kylewetton/pedal-division-kicad-library/resources/125B_design_template.pdf

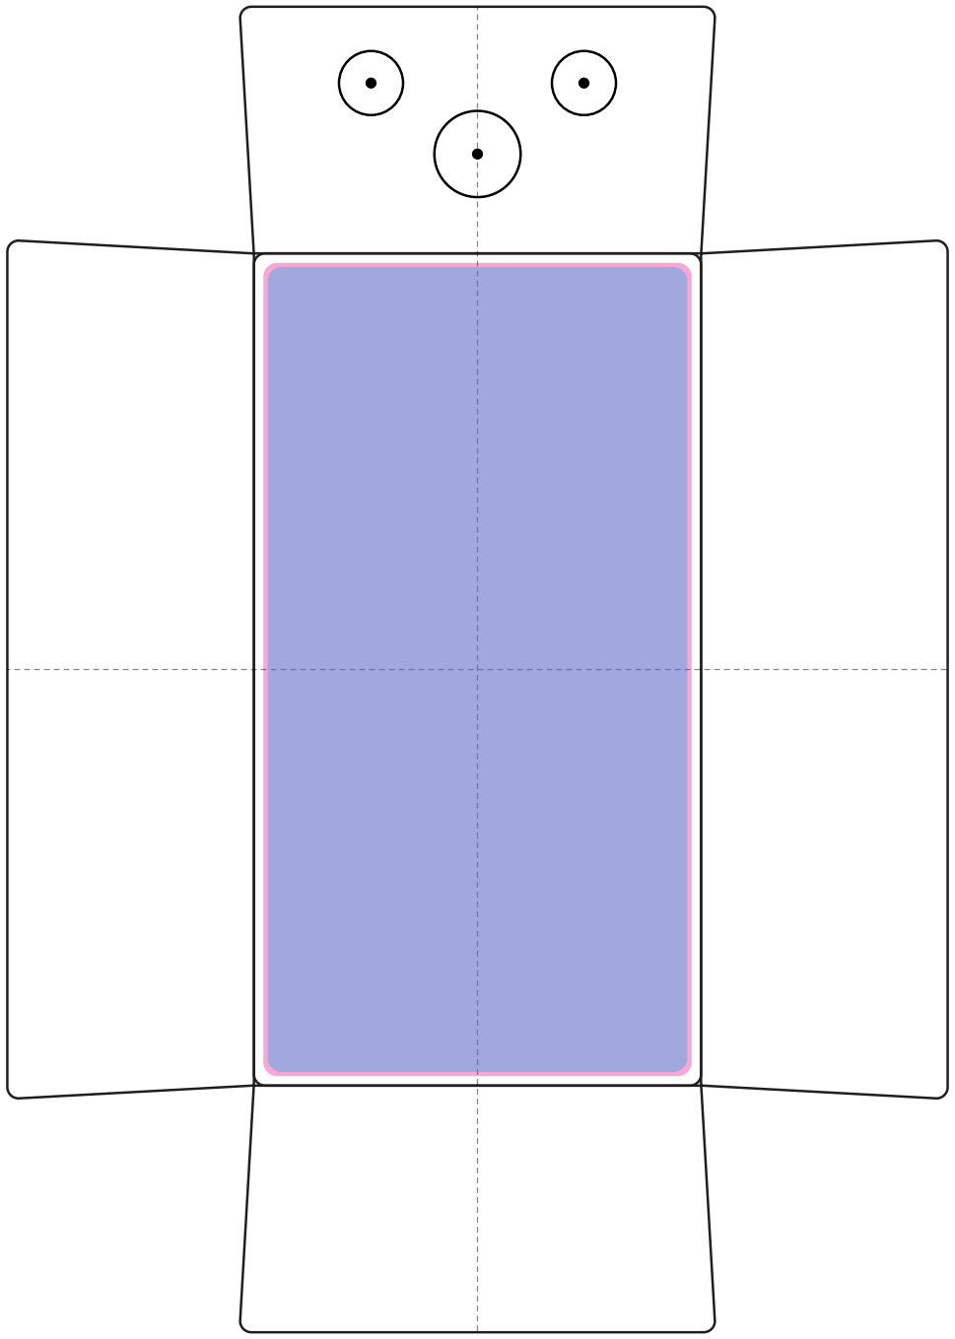
[picture p1: figure]
