kylewetton/pedal-division-kicad-library/resources/1590A_design_template.pdf

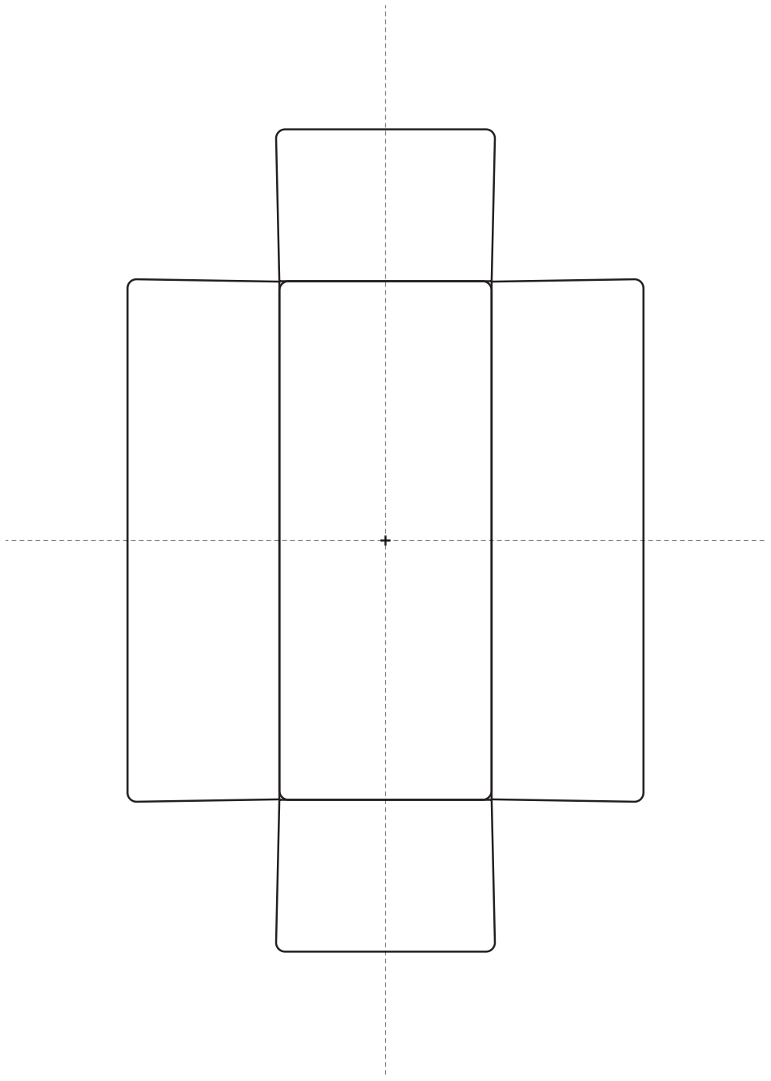
[picture p2: figure]
