kylewetton/pedal-division-kicad-library/resources/octave-up-pcb-reference.pdf

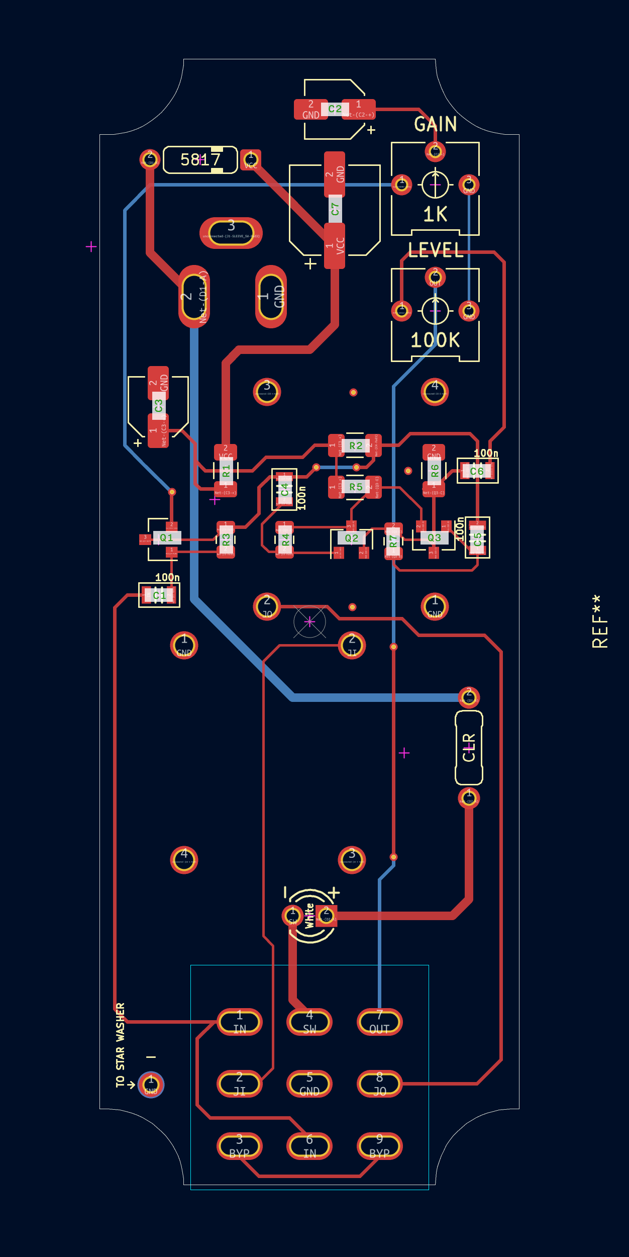
[picture p3: page 1]

C2C7

C3

R1
C4 R4

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
