kylewetton/pedal-division-kicad-library/resources/fuzz-face-tracing-reference.png

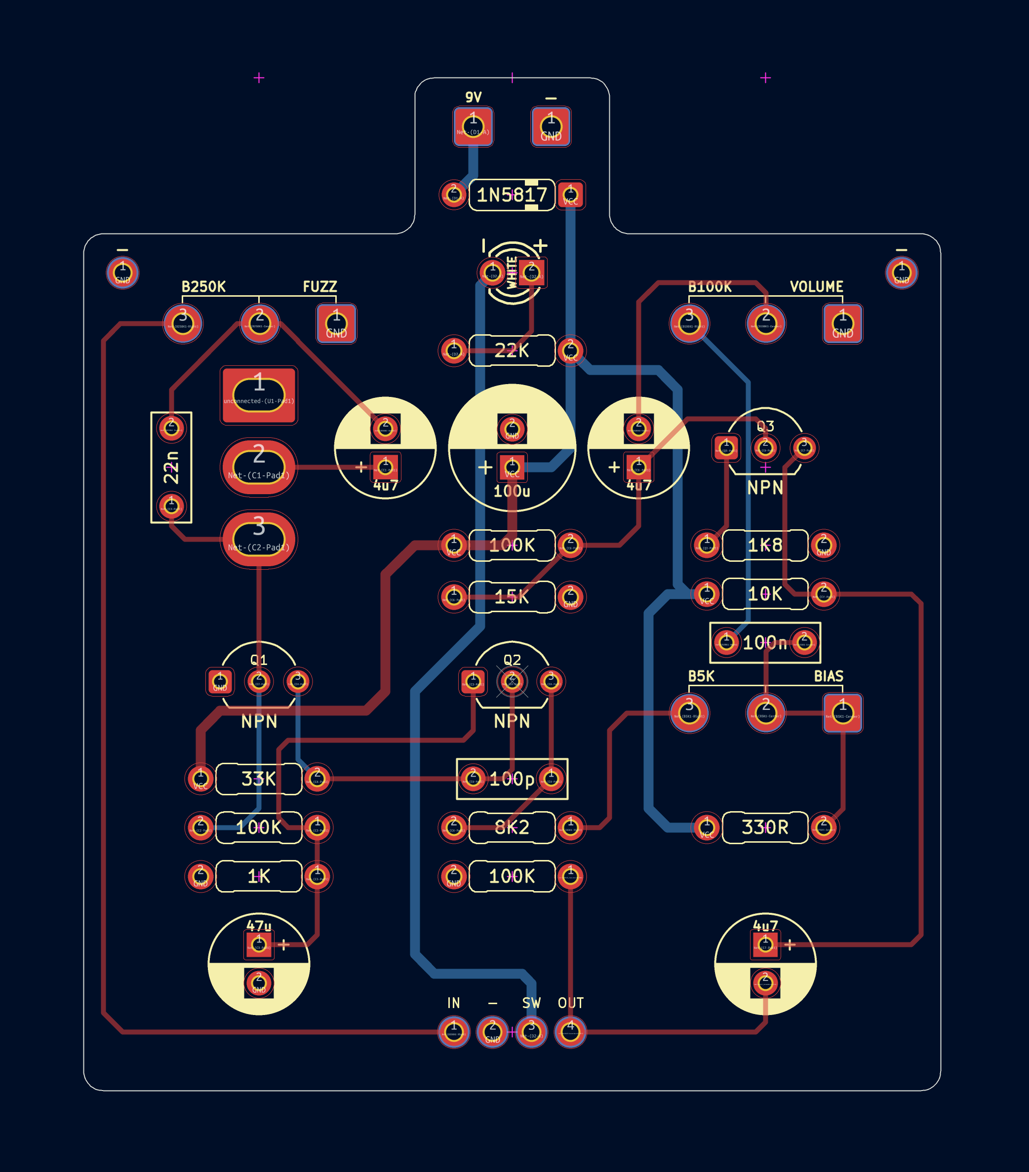
resources/fuzz-face-tracing-reference.png
