kylewetton/pedal-division-kicad-library/resources/modded-fuzz-face-schematic.png

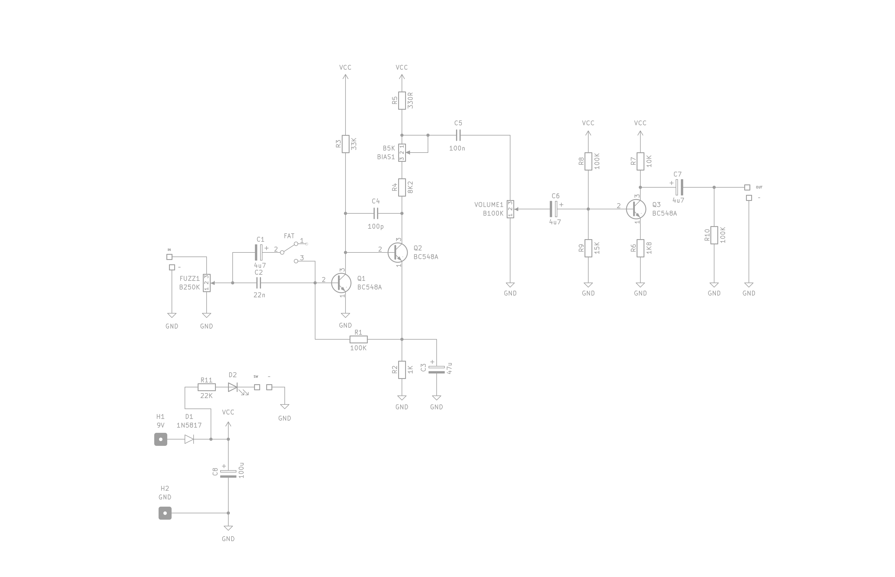
resources/modded-fuzz-face-schematic.png
