kylewetton/pedal-division-kicad-library/resources/push-me-pull-you.png

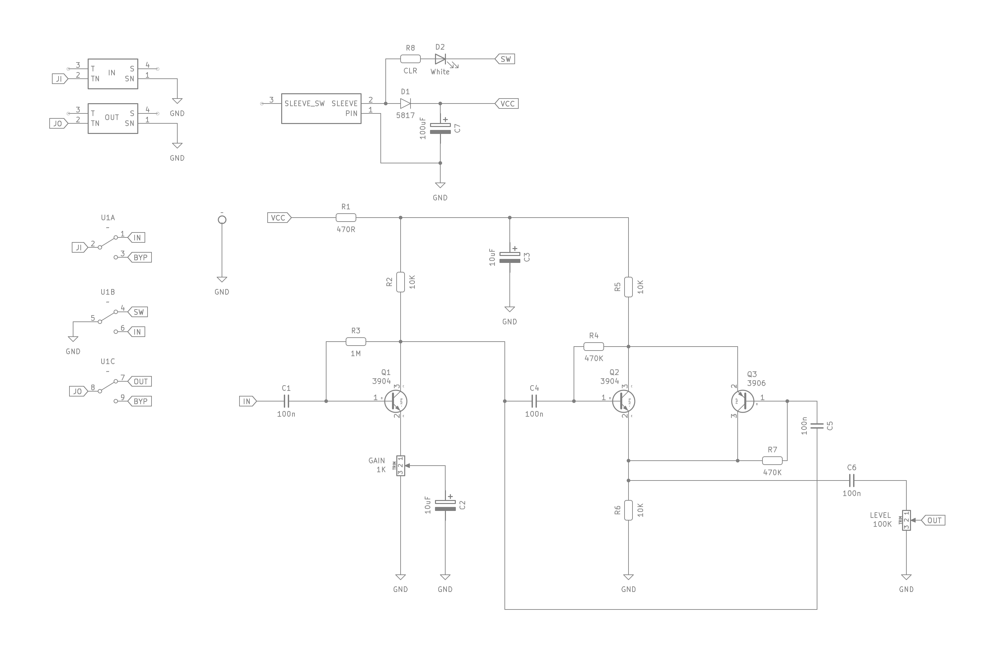
resources/push-me-pull-you.png
