kylewetton/pedal-division-kicad-library/3d_models/1590BB_Drilled_Port.step

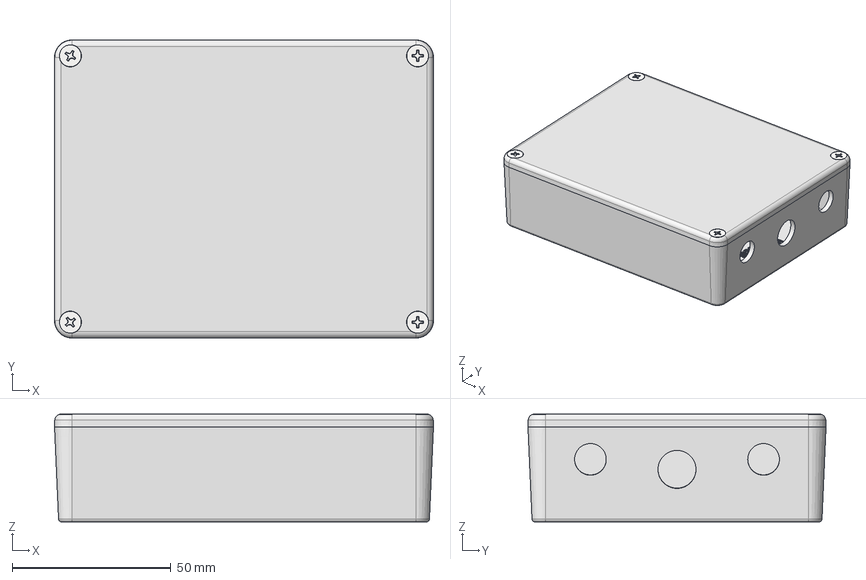
[picture p7: CAD file, 2025-09-15]
3d_models/1590BB_Drilled_Port.step
119.5 x 94.0 x 34.0 mm
