kylewetton/pedal-division-kicad-library/3d_models/R_LDR_5.1x4.3mm_P3.4mm_Vertical.step

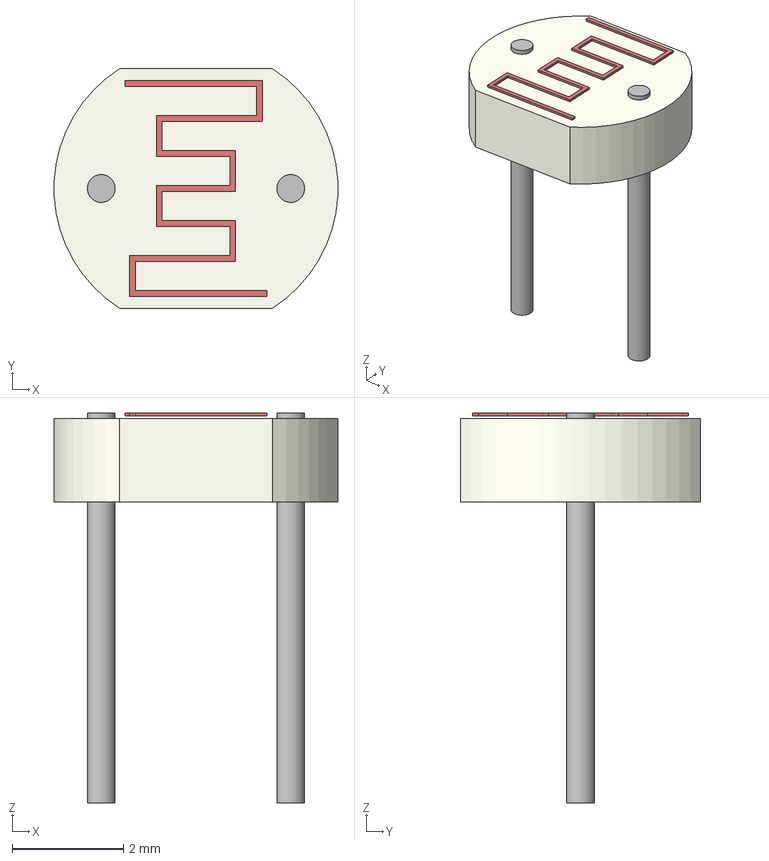
[picture p8: CAD file, 2025-09-12]
3d_models/R_LDR_5.1x4.3mm_P3.4mm_Vertical.step
5.09 x 4.30 x 7.00 mm
