kylewetton/pedal-division-kicad-library/3d_models/mini-slide-dpdt.stp

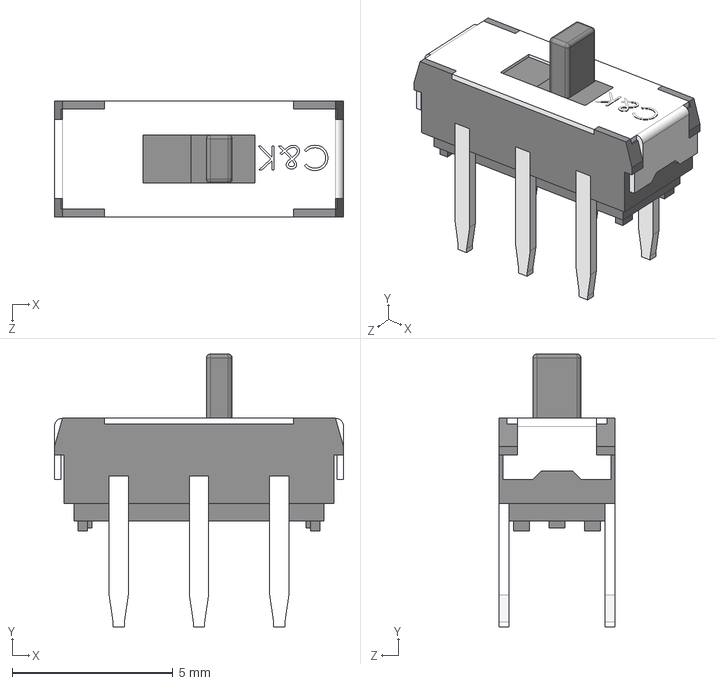
[picture p9: CAD file, 2025-09-12]
3d_models/mini-slide-dpdt.stp
9.00 x 8.50 x 3.60 mm
