kylewetton/pedal-division-kicad-library/3d_models/DIP-8_W7.62mm.step

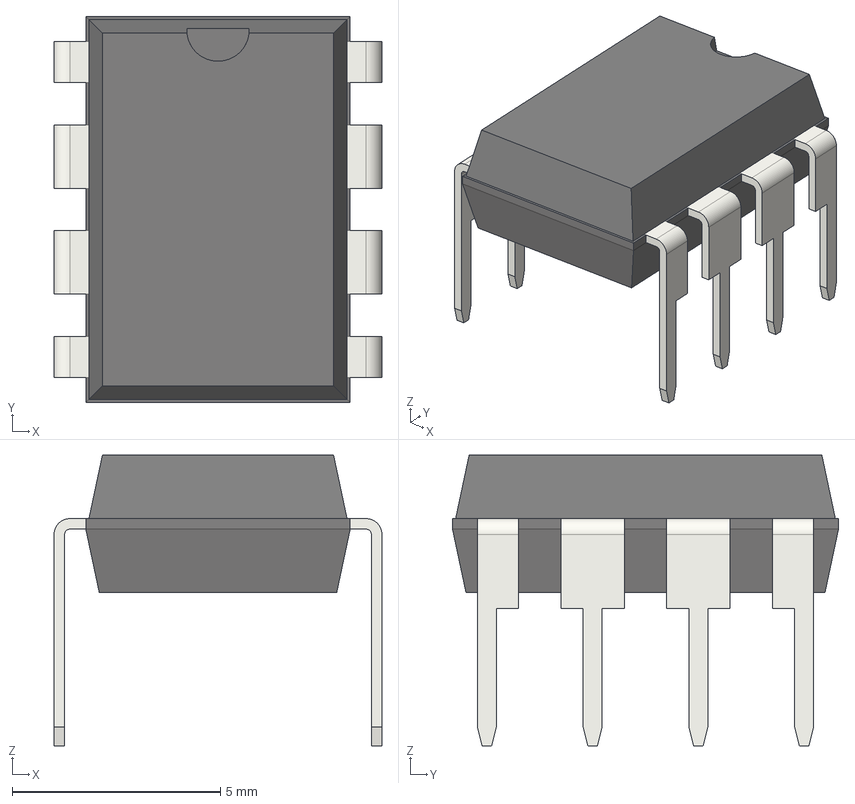
[picture p10: CAD file, 2025-09-12]
3d_models/DIP-8_W7.62mm.step
7.87 x 9.27 x 6.98 mm
