kylewetton/pedal-division-kicad-library/3d_models/SOIC-8-N7_3.9x4.9mm_P1.27mm.step

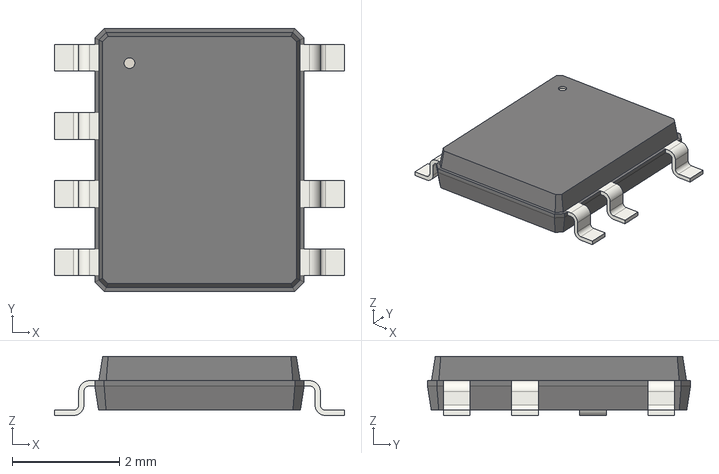
[picture p11: CAD file, 2025-09-12]
3d_models/SOIC-8-N7_3.9x4.9mm_P1.27mm.step
5.40 x 4.90 x 1.10 mm
