kylewetton/pedal-division-kicad-library/3d_models/1590BB2.stp

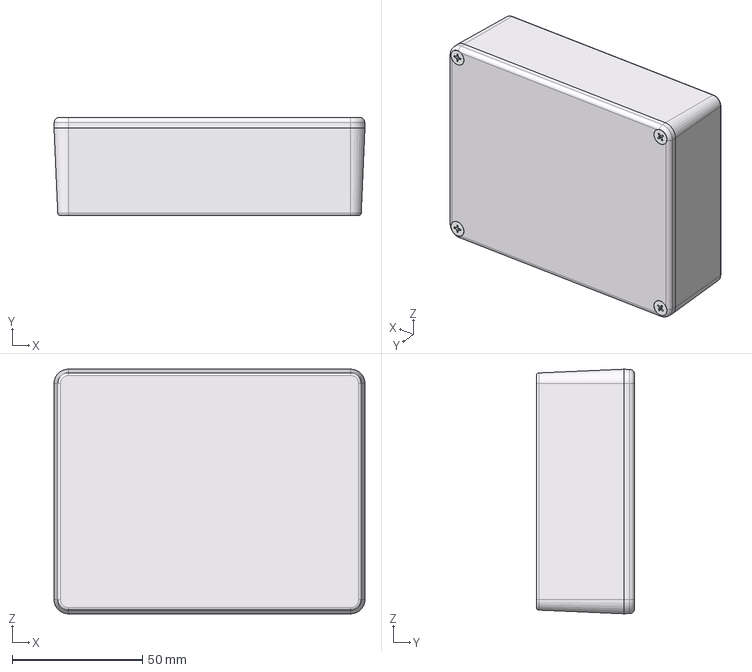
[picture p12: CAD file, 2025-09-12]
3d_models/1590BB2.stp
119.5 x 37.8 x 94.0 mm
1590BB2 BOX
1590BB-BBS-C LID
