kylewetton/pedal-division-kicad-library/3d_models/1590DD.stp

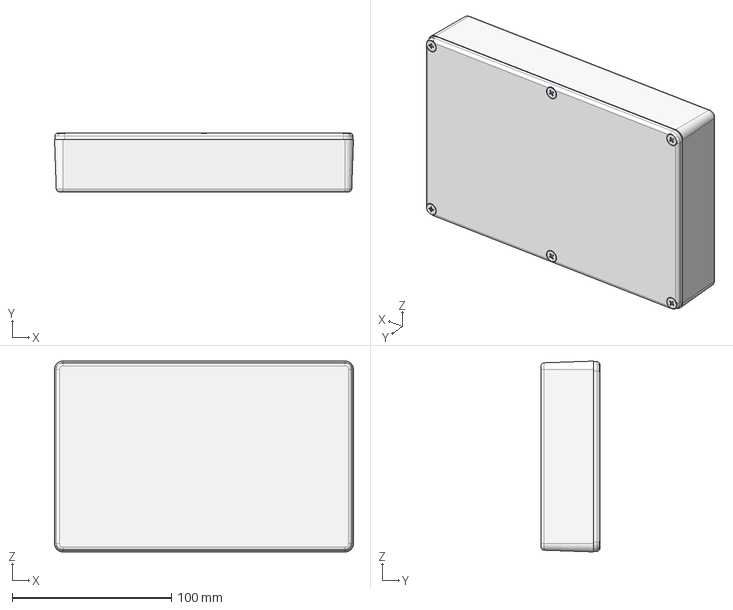
[picture p13: CAD file, 2025-09-12]
3d_models/1590DD.stp
188.0 x 37.0 x 120.0 mm
