kylewetton/pedal-division-kicad-library/3d_models/1590A.stp

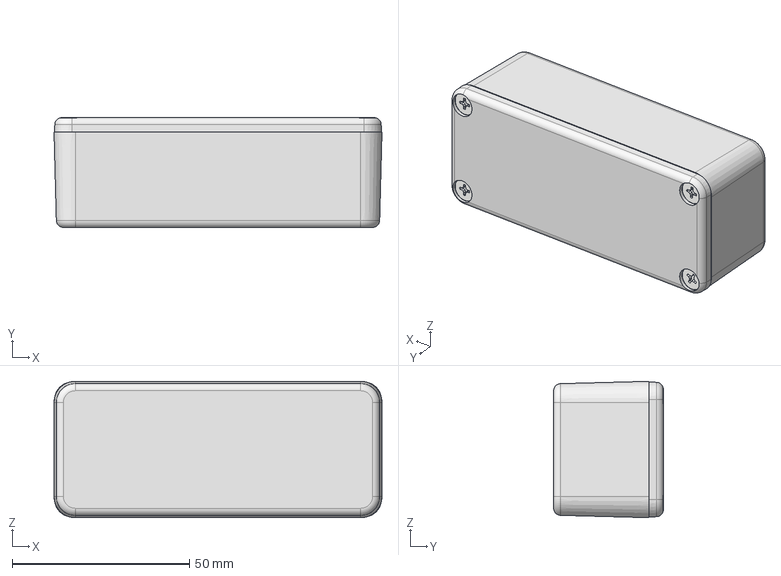
[picture p14: CAD file, 2025-09-12]
3d_models/1590A.stp
92.6 x 31.0 x 38.5 mm
