kylewetton/pedal-division-kicad-library/3d_models/3PDT_FS.step

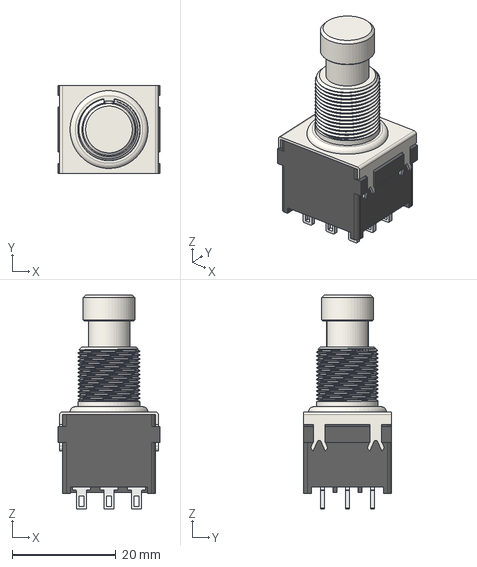
[picture p15: CAD file, 2025-09-12]
3d_models/3PDT_FS.step
19.6 x 17.0 x 41.2 mm
