kylewetton/pedal-division-kicad-library/3d_models/3DPT_switch.step

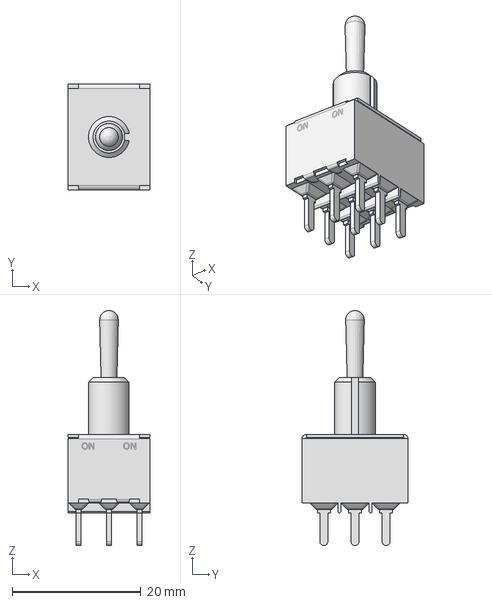
[picture p16: CAD file, 2025-09-12]
3d_models/3DPT_switch.step
12.7 x 16.5 x 36.4 mm
