kylewetton/pedal-division-kicad-library/3d_models/C_Rect_L7.2mm_W5.5mm_P5.00mm_FKS2_FKP2_MKS2_MKP2.step

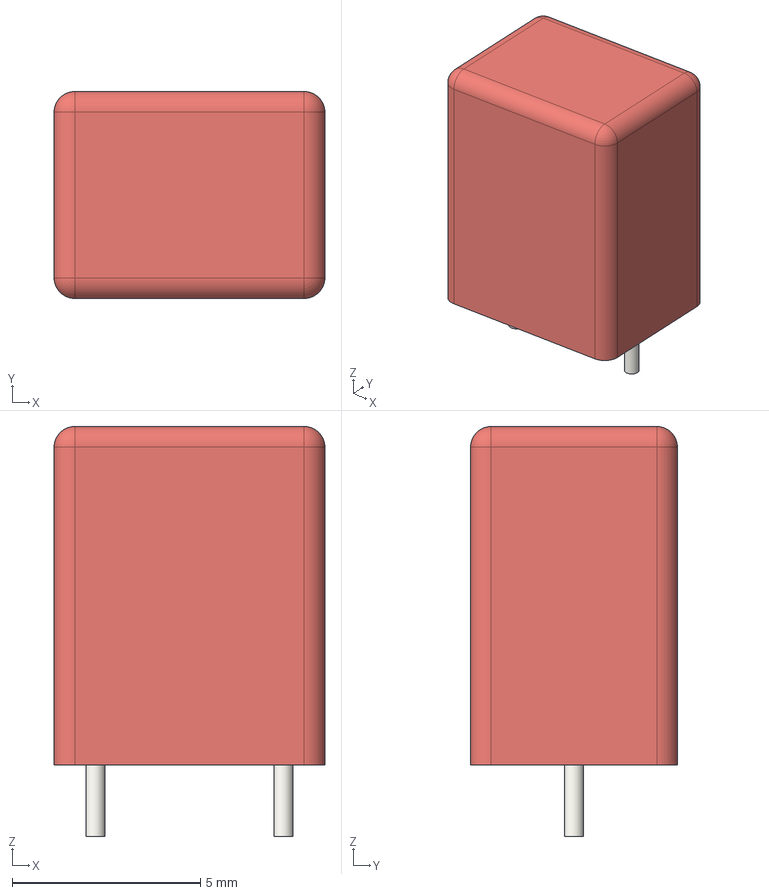
[picture p17: CAD file, 2025-09-12]
3d_models/C_Rect_L7.2mm_W5.5mm_P5.00mm_FKS2_FKP2_MKS2_MKP2.step
7.20 x 5.50 x 10.9 mm
