kylewetton/pedal-division-kicad-library/3d_models/1590BX.stp

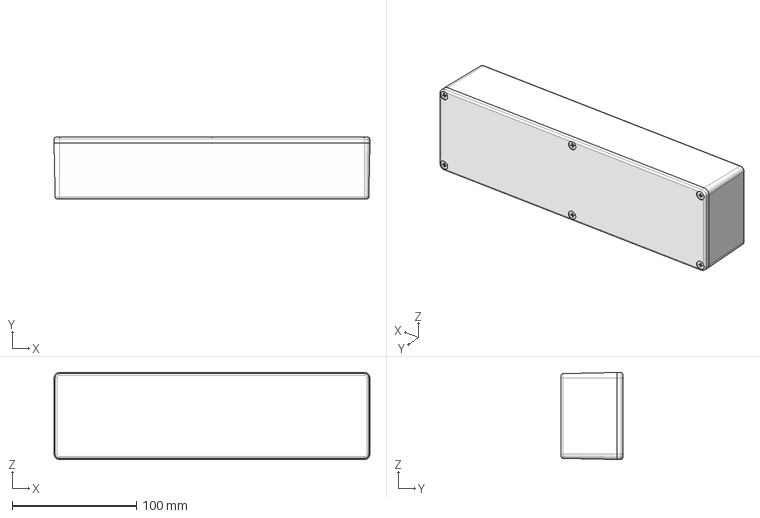
[picture p18: CAD file, 2025-09-12]
3d_models/1590BX.stp
254.0 x 49.5 x 70.0 mm
1590BX BOX
1590BX LID
