kylewetton/pedal-division-kicad-library/3d_models/1590XX.stp

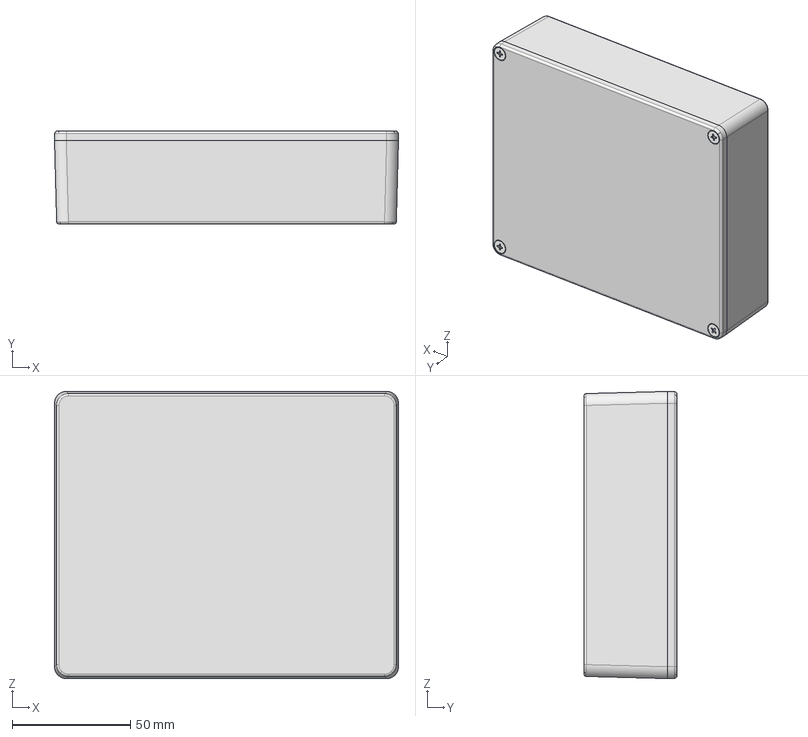
[picture p19: CAD file, 2025-09-12]
3d_models/1590XX.stp
145.2 x 39.3 x 121.2 mm
