kylewetton/pedal-division-kicad-library/3d_models/RV16AF-41.step

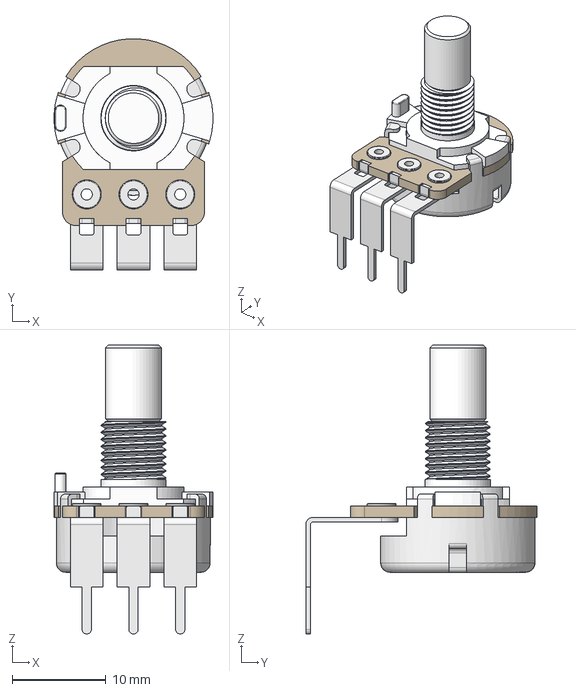
[picture p21: CAD file, 2025-09-12]
3d_models/RV16AF-41.step
17.0 x 24.7 x 30.9 mm
