kylewetton/pedal-division-kicad-library/3d_models/A-1121.step

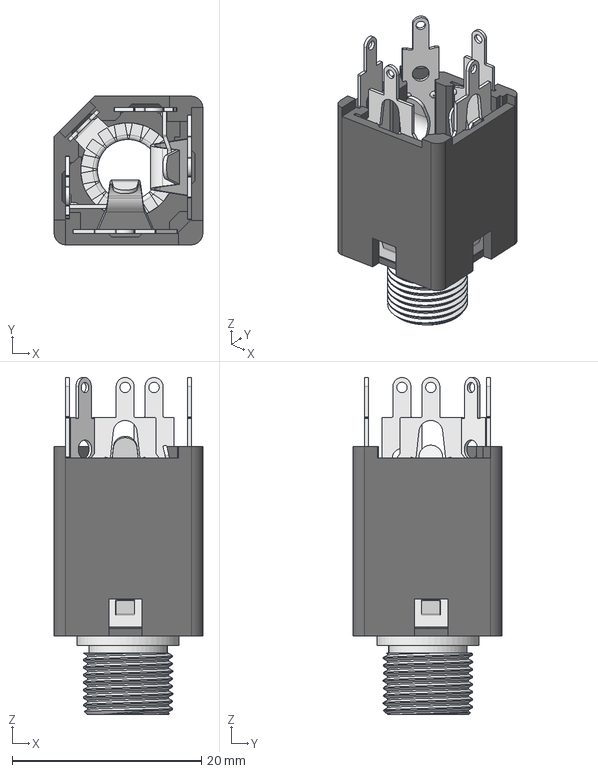
[picture p22: CAD file, 2025-09-12]
3d_models/A-1121.step
15.7 x 15.7 x 35.6 mm
