kylewetton/pedal-division-kicad-library/3d_models/Led_3mm.step

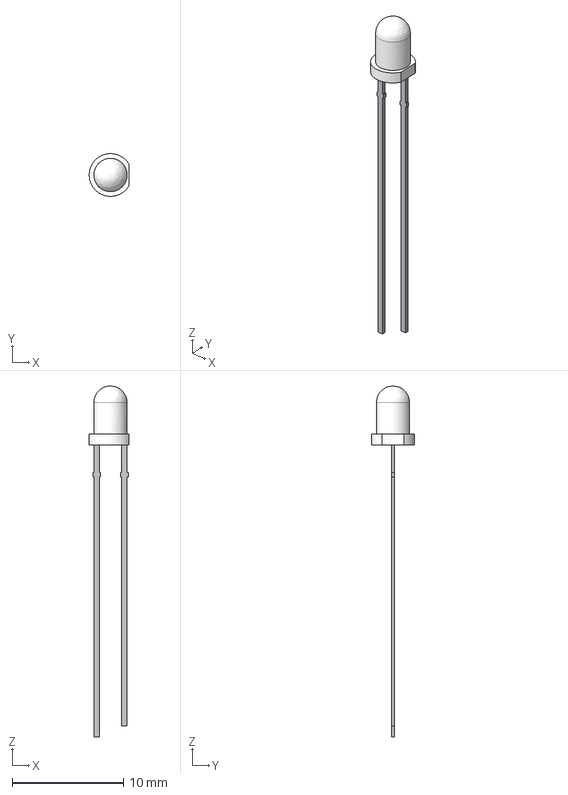
[picture p23: CAD file, 2025-09-12]
3d_models/Led_3mm.step
3.58 x 3.85 x 31.6 mm
