kylewetton/pedal-division-kicad-library/3d_models/LED_0603_1608Metric_Castellated.step

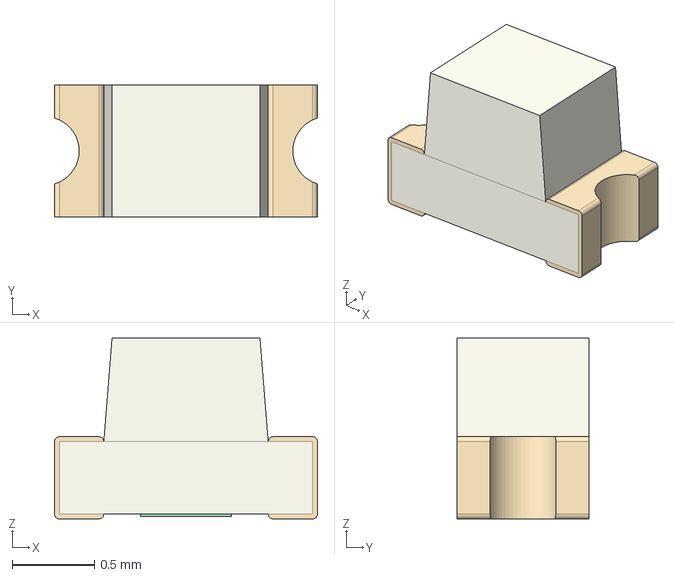
[picture p24: CAD file, 2025-09-12]
3d_models/LED_0603_1608Metric_Castellated.step
1.60 x 0.8 x 1.10 mm
