kylewetton/pedal-division-kicad-library/3d_models/11.stp

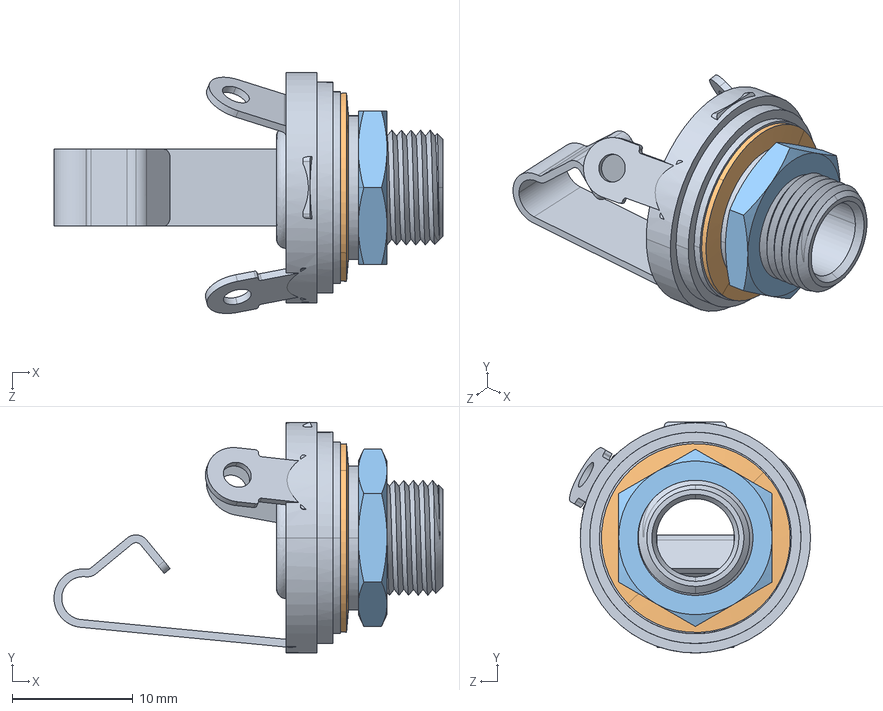
[picture p25: CAD file, 2025-09-12]
3d_models/11.stp
32.2 x 19.1 x 19.9 mm
Washer
Nut
