kylewetton/pedal-division-kicad-library/3d_models/TO-92_Inline.step

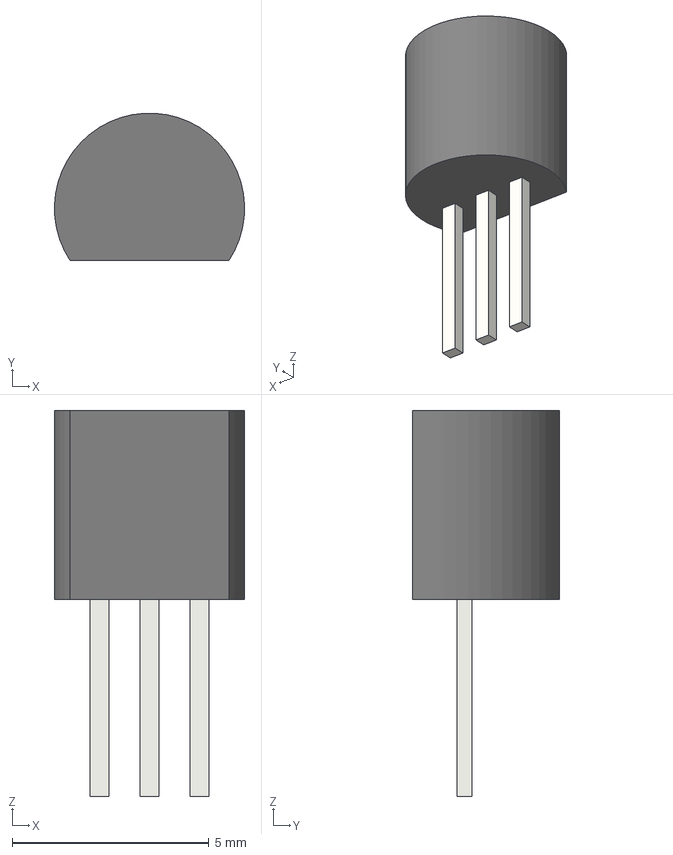
[picture p26: CAD file, 2025-09-12]
3d_models/TO-92_Inline.step
4.83 x 3.74 x 9.80 mm
