kylewetton/pedal-division-kicad-library/3d_models/C_0805_2012Metric.step

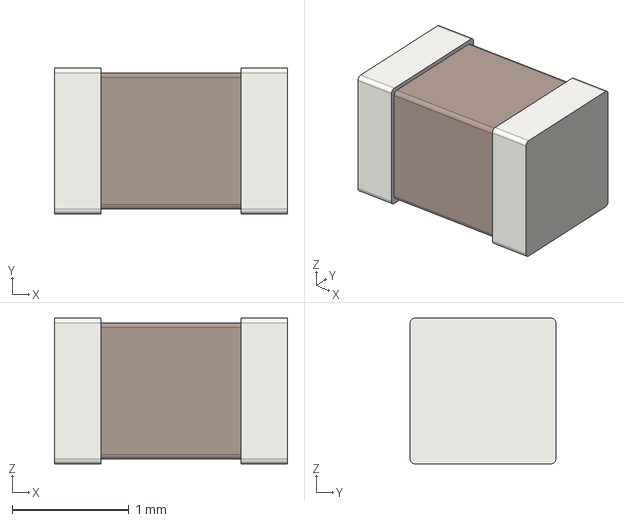
[picture p27: CAD file, 2025-09-12]
3d_models/C_0805_2012Metric.step
2.00 x 1.25 x 1.25 mm
