kylewetton/pedal-division-kicad-library/3d_models/1590N1_Drilled_Top.step

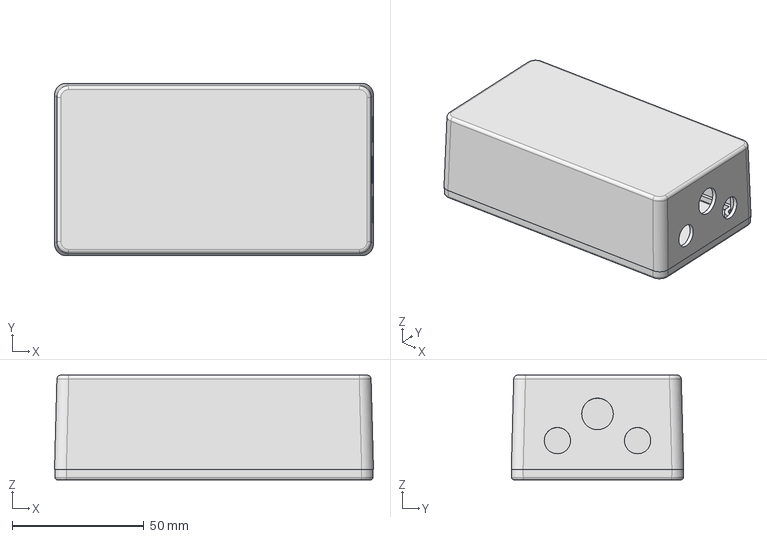
[picture p28: CAD file, 2025-09-12]
3d_models/1590N1_Drilled_Top.step
121.2 x 65.5 x 39.8 mm
