kylewetton/pedal-division-kicad-library/3d_models/1_4w_resistor.step

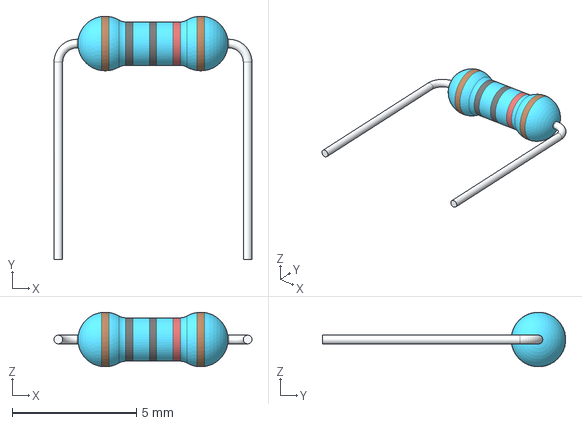
[picture p29: CAD file, 2025-09-12]
3d_models/1_4w_resistor.step
7.97 x 9.80 x 2.19 mm
