kylewetton/pedal-division-kicad-library/3d_models/1N4007P8.STEP

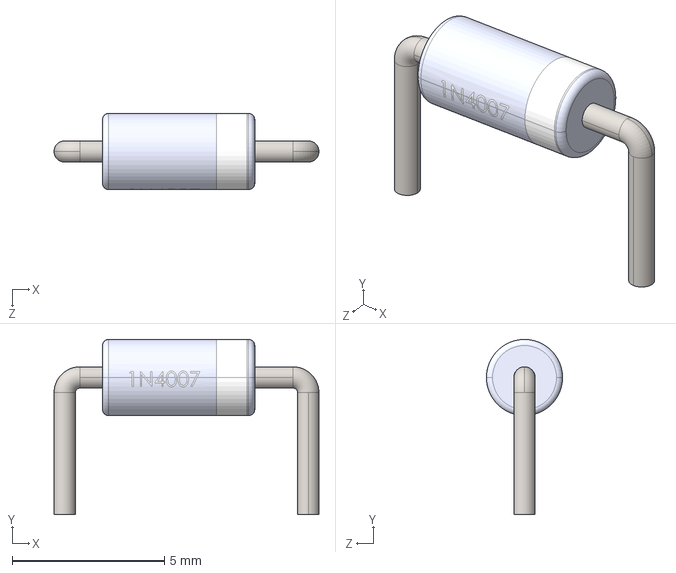
[picture p30: CAD file, 2025-09-12]
3d_models/1N4007P8.STEP
8.70 x 5.75 x 2.50 mm
Lead1
