kylewetton/pedal-division-kicad-library/3d_models/SOIC-14_3.9x8.7mm_P1.27mm.step

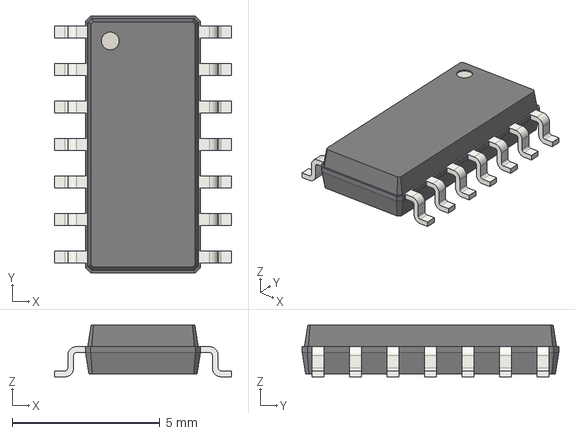
[picture p31: CAD file, 2025-09-12]
3d_models/SOIC-14_3.9x8.7mm_P1.27mm.step
6.00 x 8.70 x 1.75 mm
