kylewetton/pedal-division-kicad-library/3d_models/1590N1.stp

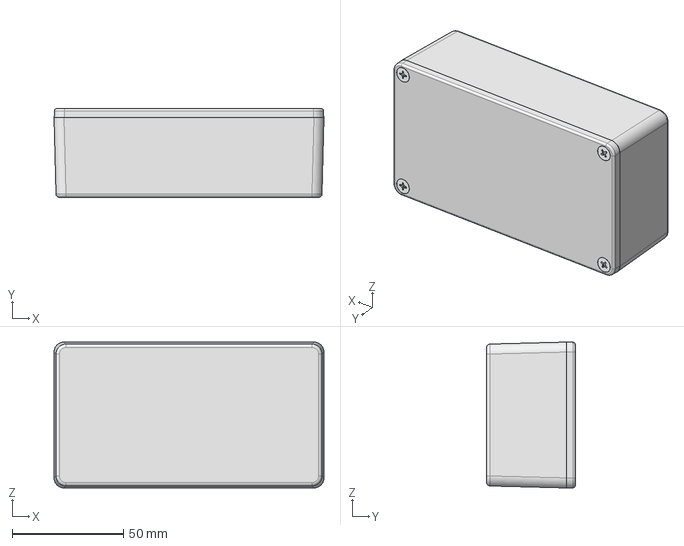
[picture p32: CAD file, 2025-09-12]
3d_models/1590N1.stp
121.2 x 39.8 x 65.5 mm
