kylewetton/pedal-division-kicad-library/3d_models/C_1206_3216Metric.step

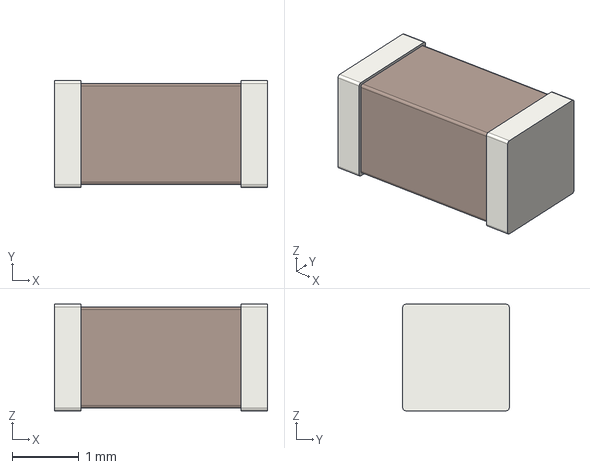
[picture p33: CAD file, 2025-09-12]
3d_models/C_1206_3216Metric.step
3.20 x 1.60 x 1.60 mm
