kylewetton/pedal-division-kicad-library/3d_models/transformer_42TM series.step

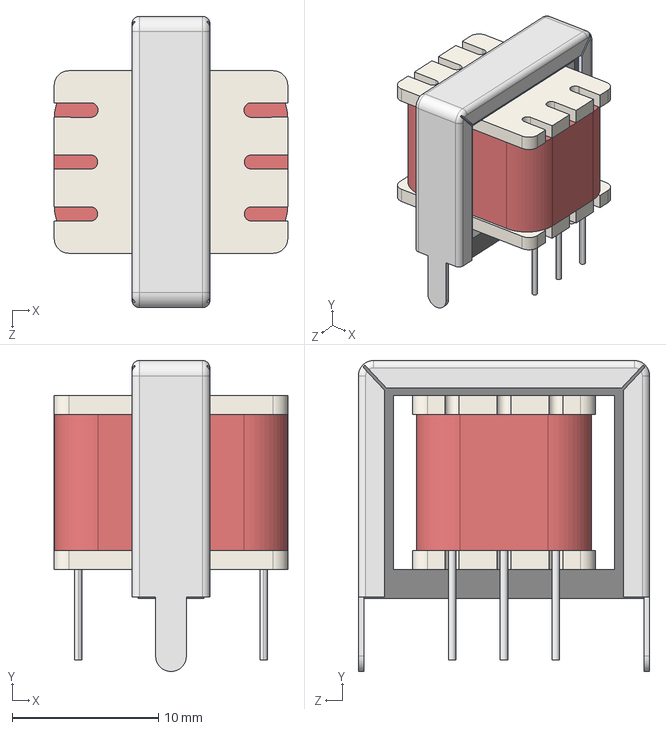
[picture p34: CAD file, 2025-09-12]
3d_models/transformer_42TM series.step
16.0 x 21.3 x 19.9 mm
