kylewetton/pedal-division-kicad-library/3d_models/NMJ4HCD2.stp

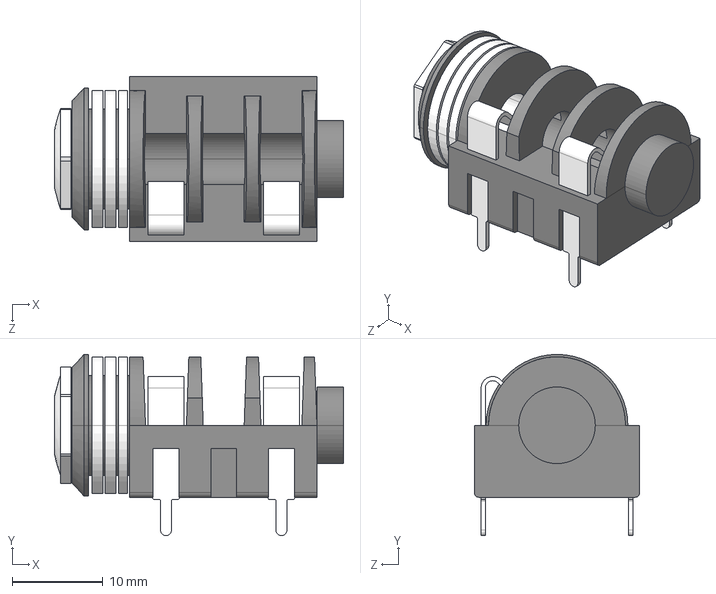
[picture p35: CAD file, 2025-09-12]
3d_models/NMJ4HCD2.stp
31.8 x 19.9 x 18.2 mm
