kylewetton/pedal-division-kicad-library/3d_models/Female Pin Header.step

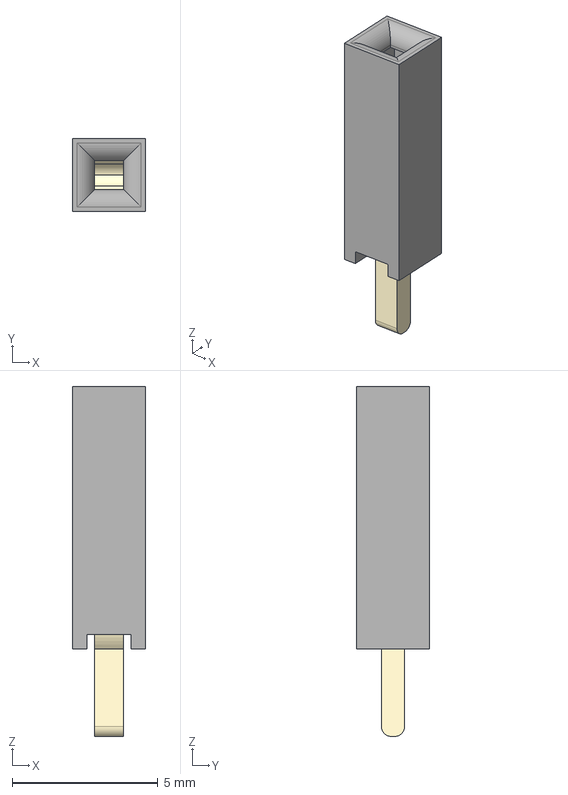
[picture p36: CAD file, 2025-09-12]
3d_models/Female Pin Header.step
2.50 x 2.50 x 12.0 mm
