kylewetton/pedal-division-kicad-library/3d_models/9mm_alpha.step

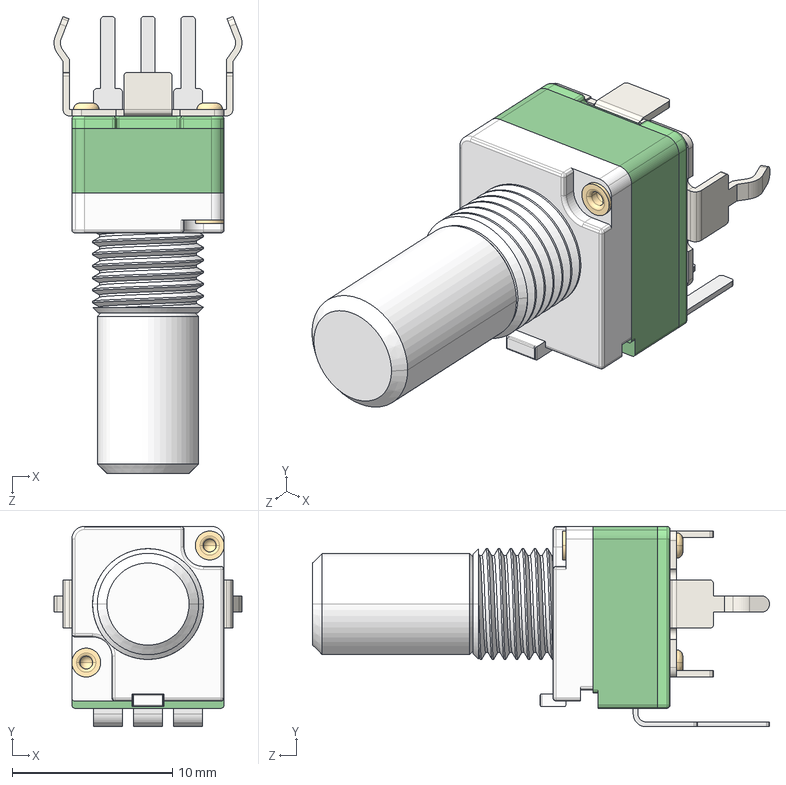
[picture p37: CAD file, 2025-09-12]
3d_models/9mm_alpha.step
11.7 x 12.5 x 28.5 mm
