kylewetton/pedal-division-kicad-library/3d_models/R_Axial_DIN0204_L3.6mm_D1.6mm_P1.90mm_Vertical.step

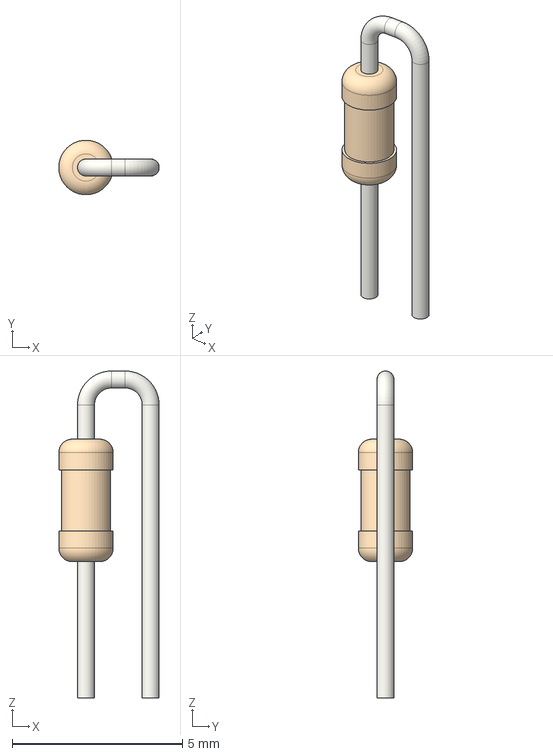
[picture p38: CAD file, 2025-09-12]
3d_models/R_Axial_DIN0204_L3.6mm_D1.6mm_P1.90mm_Vertical.step
2.95 x 1.60 x 9.60 mm
