kylewetton/pedal-division-kicad-library/3d_models/DC jack.step

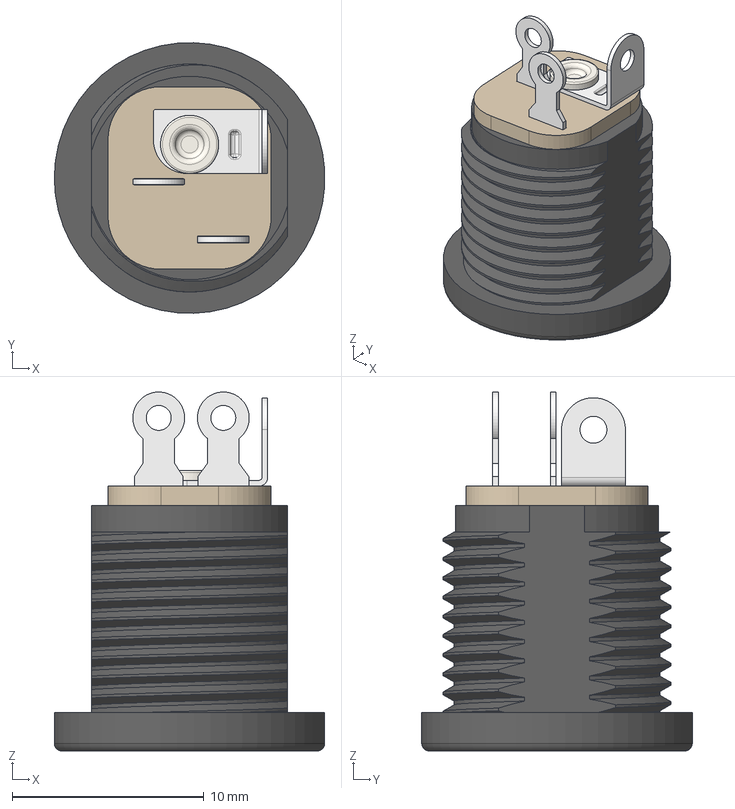
[picture p39: CAD file, 2025-09-12]
3d_models/DC jack.step
14.1 x 14.1 x 18.7 mm
