kylewetton/pedal-division-kicad-library/3d_models/1590BB.stp

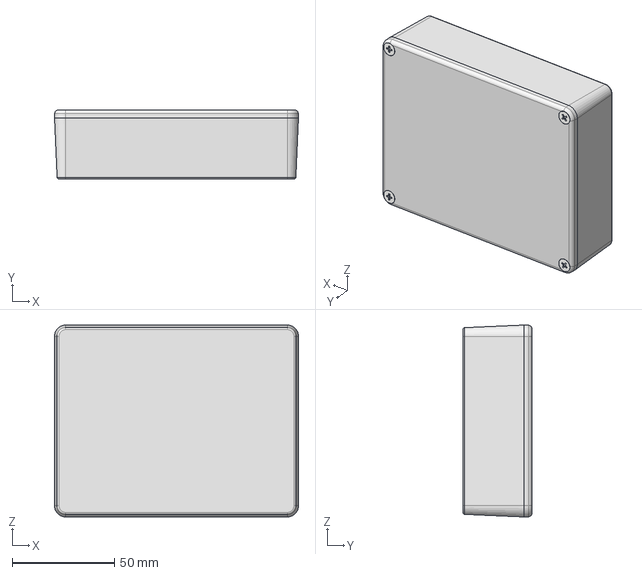
[picture p40: CAD file, 2025-09-12]
3d_models/1590BB.stp
119.5 x 34.0 x 94.0 mm
