kylewetton/pedal-division-kicad-library/3d_models/DIP-14_W7.62mm.step

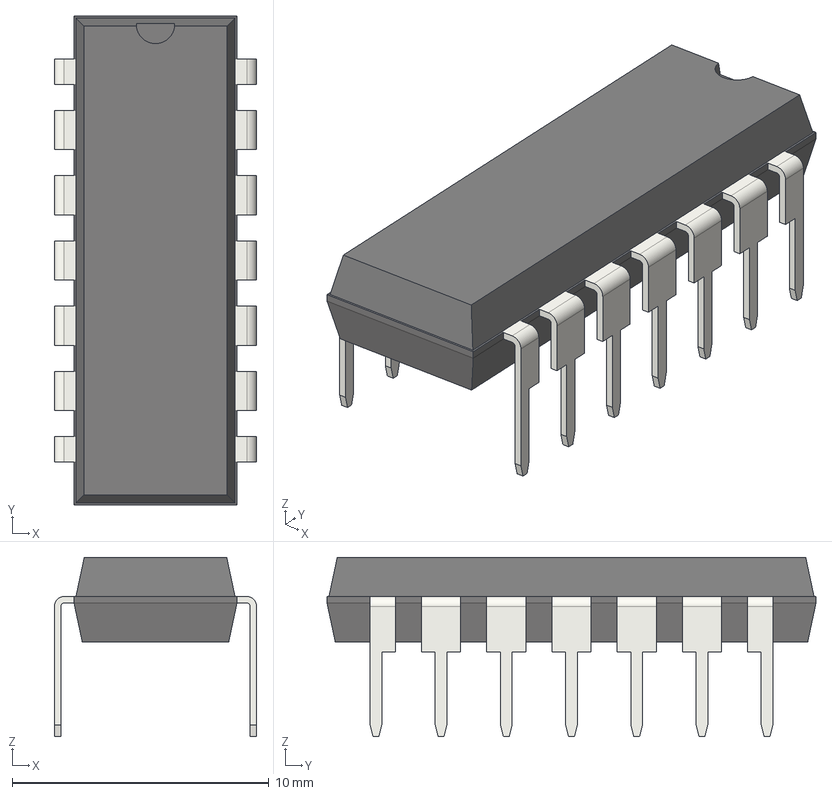
[picture p41: CAD file, 2025-09-12]
3d_models/DIP-14_W7.62mm.step
7.87 x 19.1 x 6.98 mm
