kylewetton/pedal-division-kicad-library/3d_models/3362 smd resistor pot v2.step

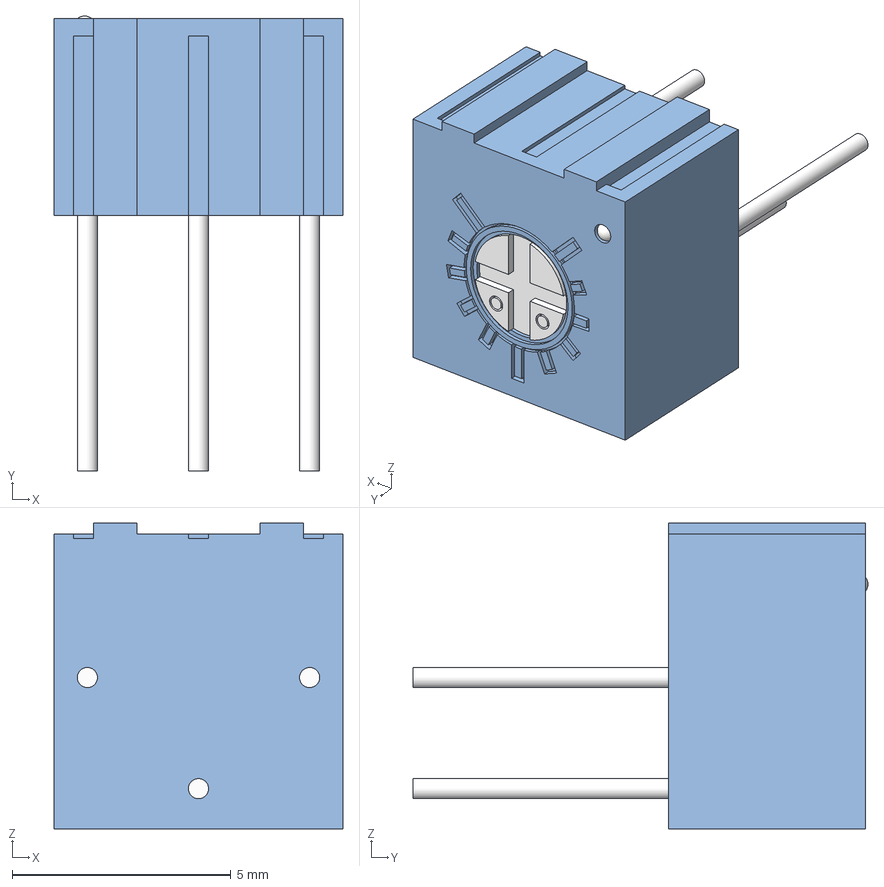
[picture p42: CAD file, 2025-09-12]
3d_models/3362 smd resistor pot v2.step
6.60 x 10.4 x 6.99 mm
