kylewetton/pedal-division-kicad-library/3d_models/C_SMD_D6.3.step

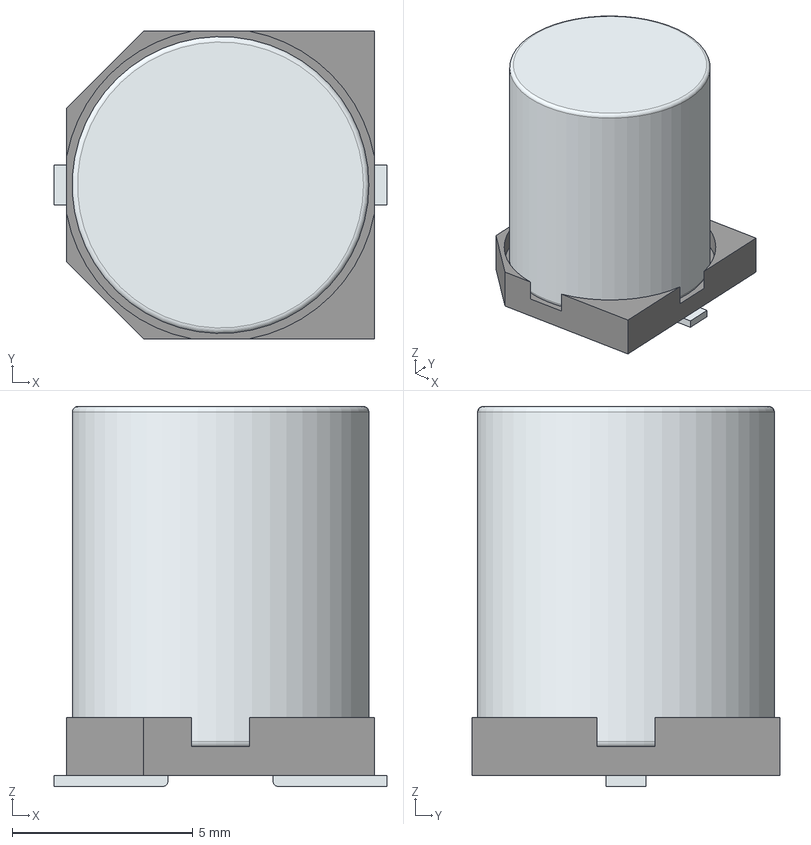
[picture p43: CAD file, 2025-09-12]
3d_models/C_SMD_D6.3.step
9.20 x 8.50 x 10.5 mm
Base
Pin1Fillet
Pin2Fillet
