kylewetton/pedal-division-kicad-library/3d_models/1590LB.stp

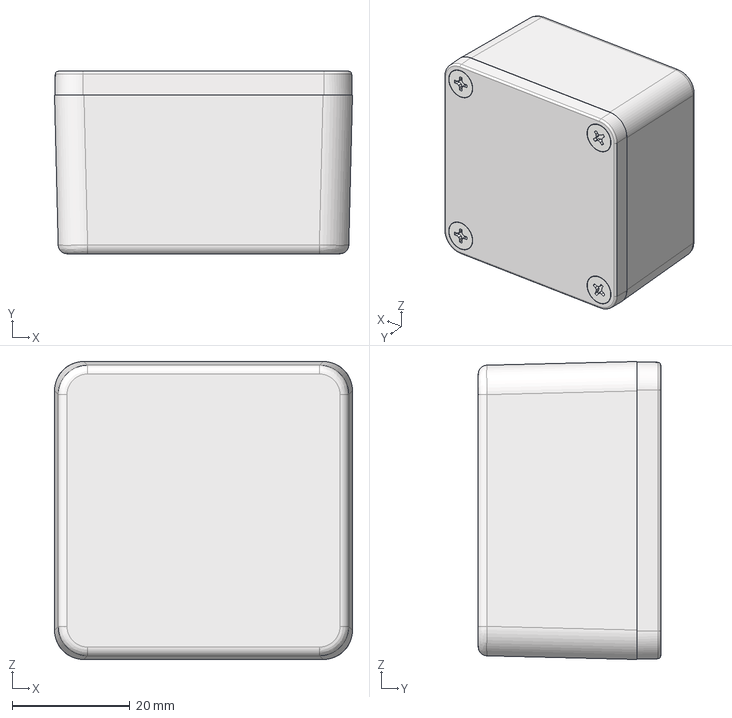
[picture p44: CAD file, 2025-09-12]
3d_models/1590LB.stp
50.6 x 31.0 x 50.6 mm
