kylewetton/pedal-division-kicad-library/3d_models/1590B.stp

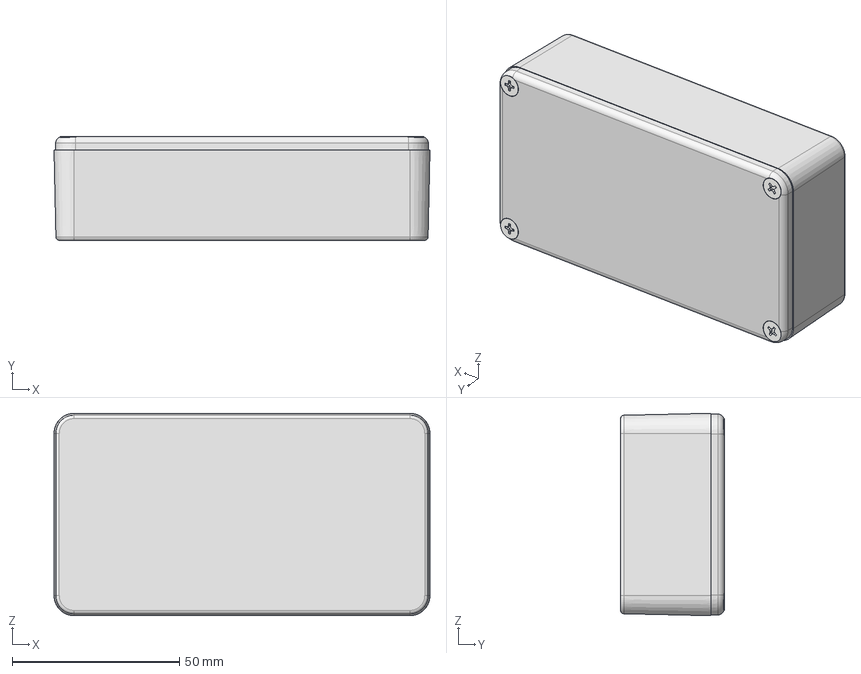
[picture p45: CAD file, 2025-09-12]
3d_models/1590B.stp
112.4 x 31.0 x 60.5 mm
