kylewetton/pedal-division-kicad-library/3d_models/16mm_alpha_long_leg.stp

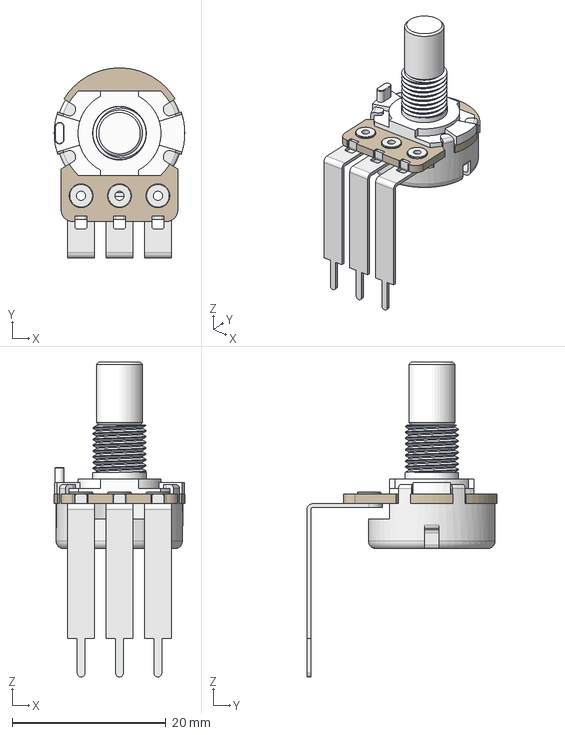
[picture p46: CAD file, 2025-09-12]
3d_models/16mm_alpha_long_leg.stp
17.0 x 24.7 x 41.0 mm
