kylewetton/pedal-division-kicad-library/3d_models/TO-92_Inline_Wide.step

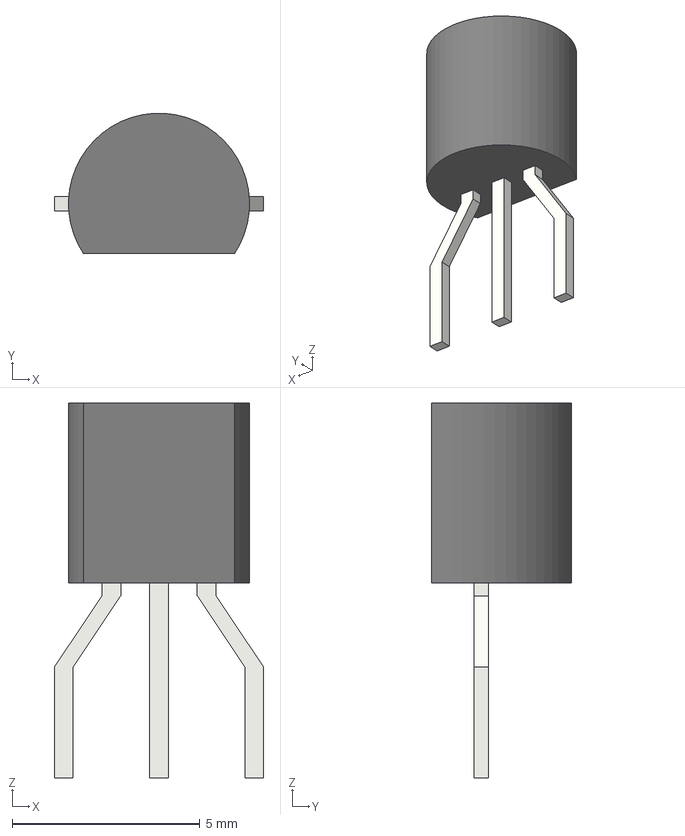
[picture p47: CAD file, 2025-09-12]
3d_models/TO-92_Inline_Wide.step
5.58 x 3.74 x 10.0 mm
