kylewetton/pedal-division-kicad-library/3d_models/C_SMD_D8.step

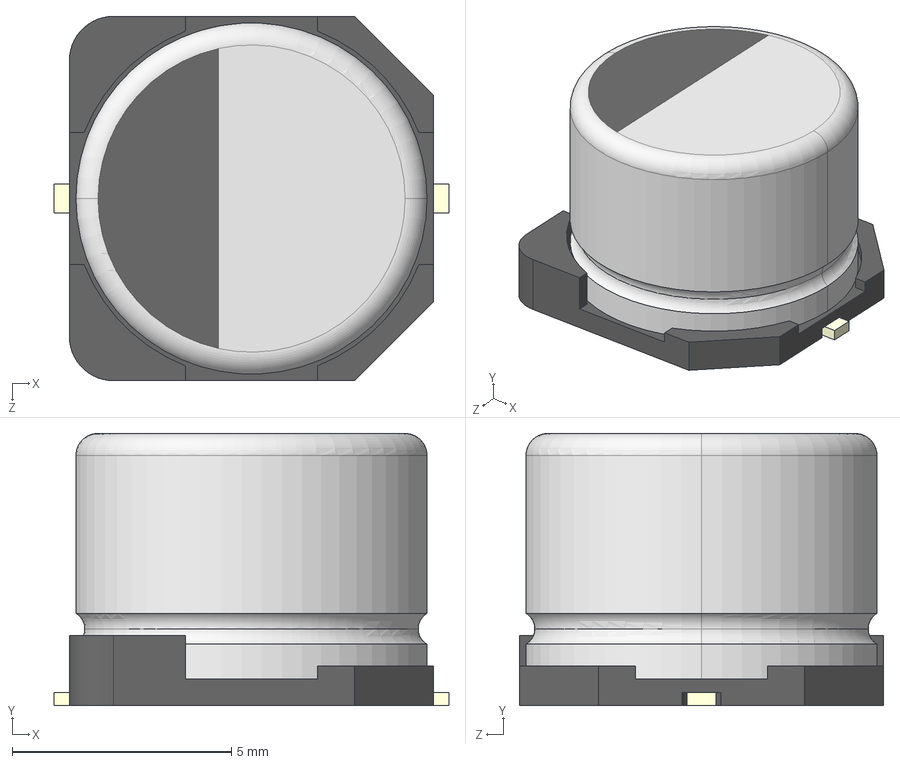
[picture p48: CAD file, 2025-09-12]
3d_models/C_SMD_D8.step
9.00 x 6.20 x 8.30 mm
標準SIZE CODE E-001
標準SIZE CODE E-002
標準SIZE CODE E-003 x 2
