kylewetton/pedal-division-kicad-library/(list of files, cad)

Other CAD files:
3d_models/1590BB_Drilled_Landscape.step
3d_models/694106301002.stp
3d_models/NMJ4HCD2_no_nut.step
