kylewetton/pedal-division-kicad-library/resources/order-switch-wiring-if-you-want-one.png

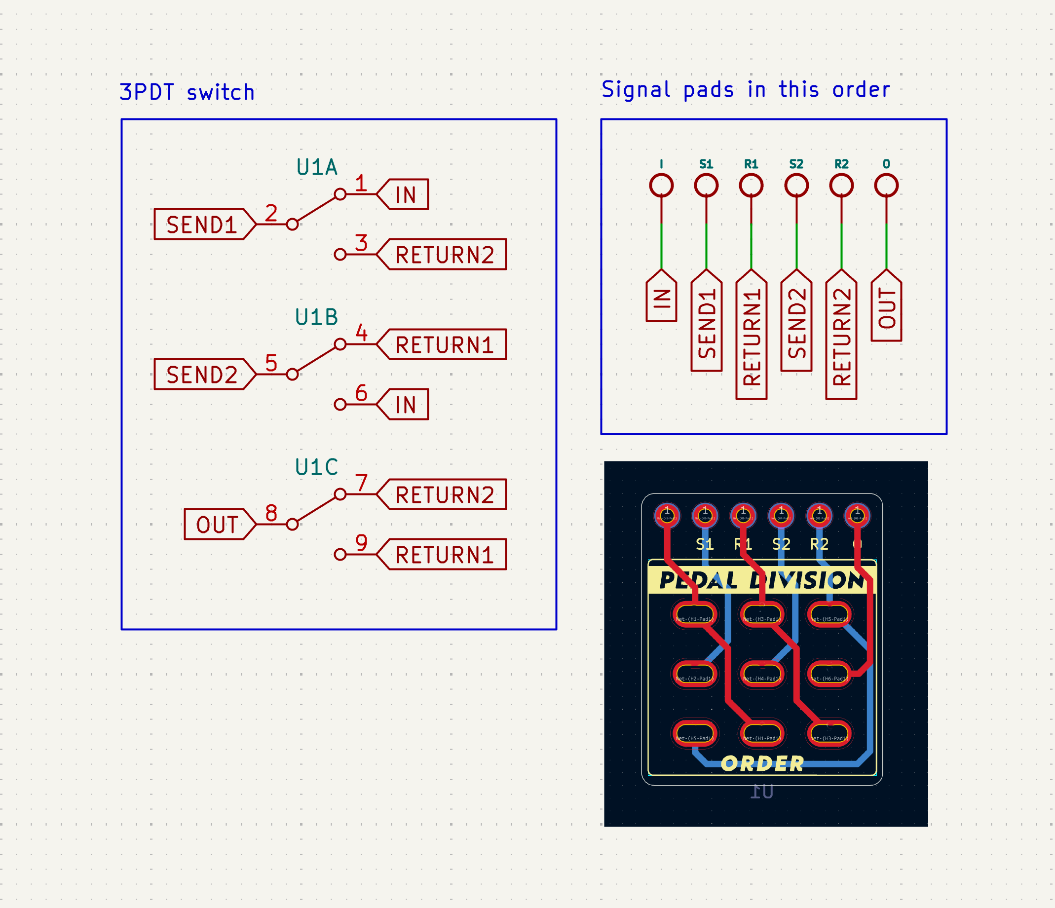
resources/order-switch-wiring-if-you-want-one.png
