kylewetton/pedal-division-kicad-library/resources/TrueBypassWiring.png

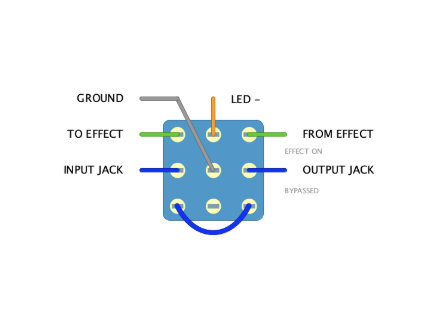
resources/TrueBypassWiring.png
