kylewetton/pedal-division-kicad-library/(commit log)

2025-09-13 add order switch
2025-09-15 More templates
    [1590BB_Drilled_Port.step]
2025-09-15 add octave bom
    [ocatve-up-bom.csv]
